shubhammishra0212/nazar-firmware/(commit log)

2026-11-02 Add main sketch: sensors, gate, belt relay, JSON protocol, loop
    Compiles for esp32:esp32:esp32 (core 3.3.12): 316 KB flash, 24 KB RAM.
2026-11-02 Add bring-up sketches 01-04: I2C scan, INA219, MPU-6050, BH1750
2026-11-02 Add bring-up sketches 05-08: DS18B20, FC-51, servo gate, relay belt
2026-11-02 Line: advance timers before handling the IR edge so stop_ms is exact
2026-11-02 Add host-side logic test of line.cpp (11 scenarios, 55 checks)
    PASS, FAIL gate timing, STOP freezing gate and inspection timers, timeout,
    HOLD/RESUME, two FAIL parts queued, continuous mode, debounce, BELT rules,
    millis() wrap. Run with: make -C test
2026-11-02 Docs and bring-up hints: belt motor now runs on 5.5 V, not 12 V
2026-11-02 Belt relay is active HIGH (BC547 board): HIGH = run, LOW = stop
    RELAY_ACTIVE_HIGH in config.h keeps the old active-LOW / float-to-release
    mode for optocoupler modules. Bring-up 08 and docs updated.
2026-11-03 Camera part trigger: SEEN command and cam setting (fw 2.1.0)
    The FC-51 misses washers on our belt, so with cam 1 (default) the console camera
    finds each washer and sends SEEN: part + inspect at once, belt off. IR is still
    reported but not counted. SET cam 0 goes back to the IR sensor. 69 host checks pass.
2026-11-03 Stop gate: arm holds rejects across the belt; calm servo (fw 2.2.0)
    kick 0 (default): for a reject the arm swings across after gate_ms and stays until
    the next good part restarts the belt or RELEASE. Arm moves in steps and its pulses
    stop when parked (no flutter). park_deg / block_deg settable live; kick 1 = old kick.
